emanueca/zenit_science/assets/files/slides/ZENIT_slide.pdf

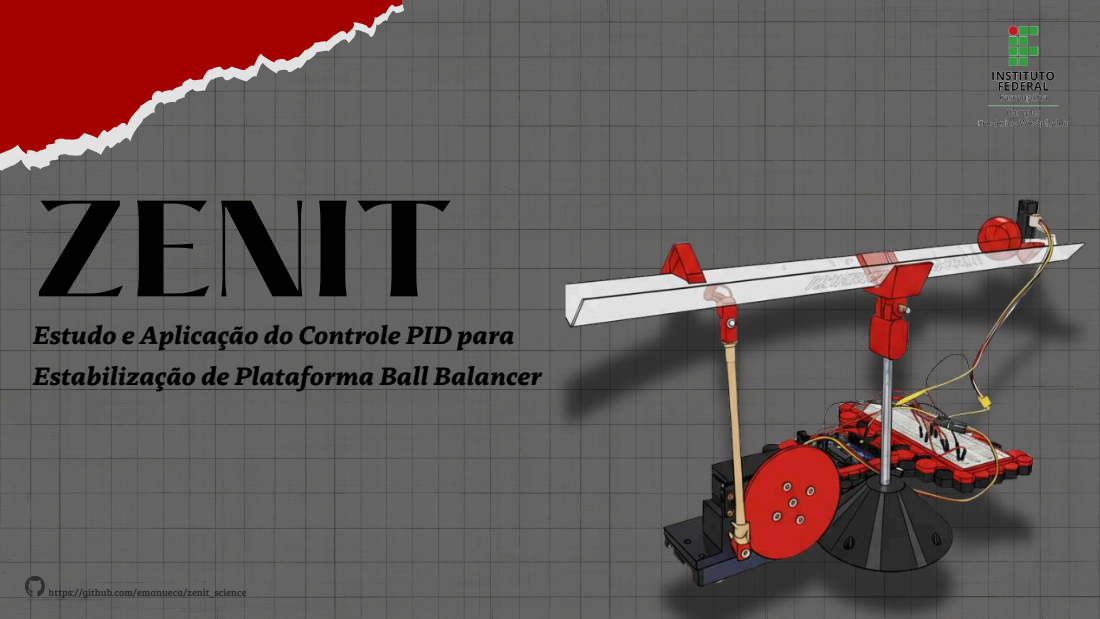
[picture p1: page 1]
ZEstudo e; EAplica; Nção do C; ontr

Tole PID para

Estabilização de Plataforma Ball Balancer

https://github.com/emanueca/zenit_science

# FFííssiiccaa

# CONCEITO CIENTÍFICO

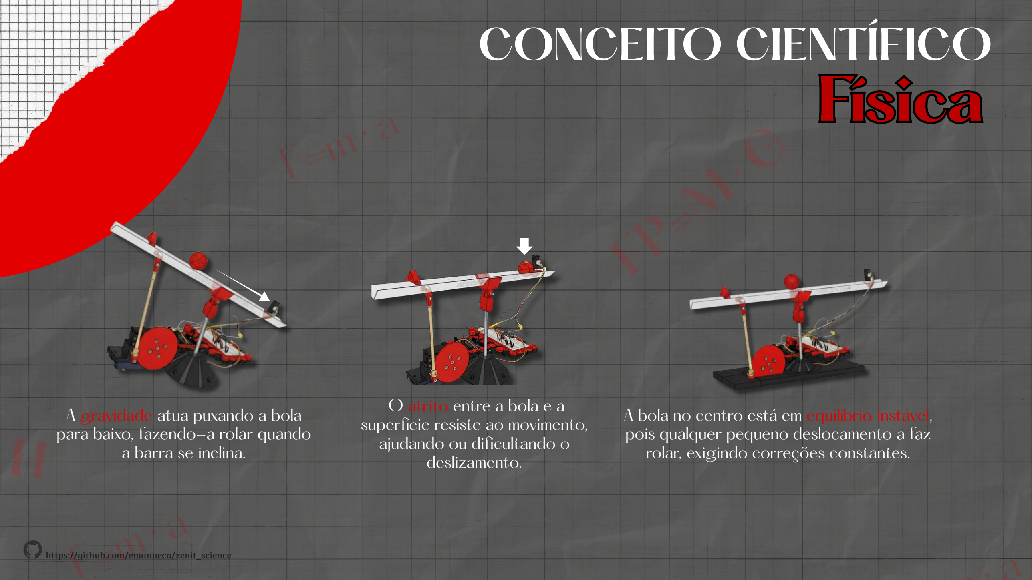
[picture p2: page 2]

## O atrito entre a bola e a

superfície resiste ao movimento,

## ajudando ou dificultando o

deslizamento.

# FP=M⋅G

H

## A gravidade atua puxando a bola para baixo, fazendo-a rolar quando

a barra se inclina.

A bola no centro está em equilíbrio instável,

## pois qualquer pequeno deslocamento a faz

rolar, exigindo correções constantes.

# F=m⋅a

# F=m⋅a

⋅a

# Proporcional :

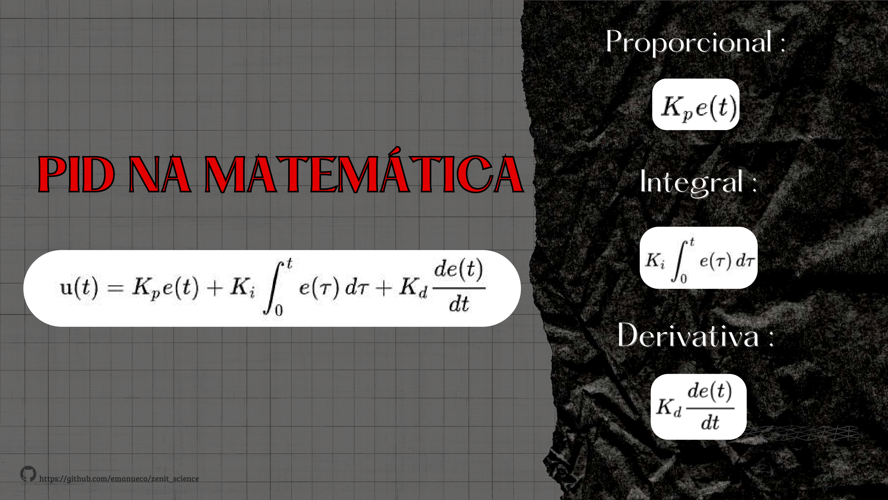
[picture p3: page 3]

# PID NA MATEMÁTICA

# Integral :

# Derivativa :

# FUNCIONAMENTO DO PROJETO

# SENSOR SHARP

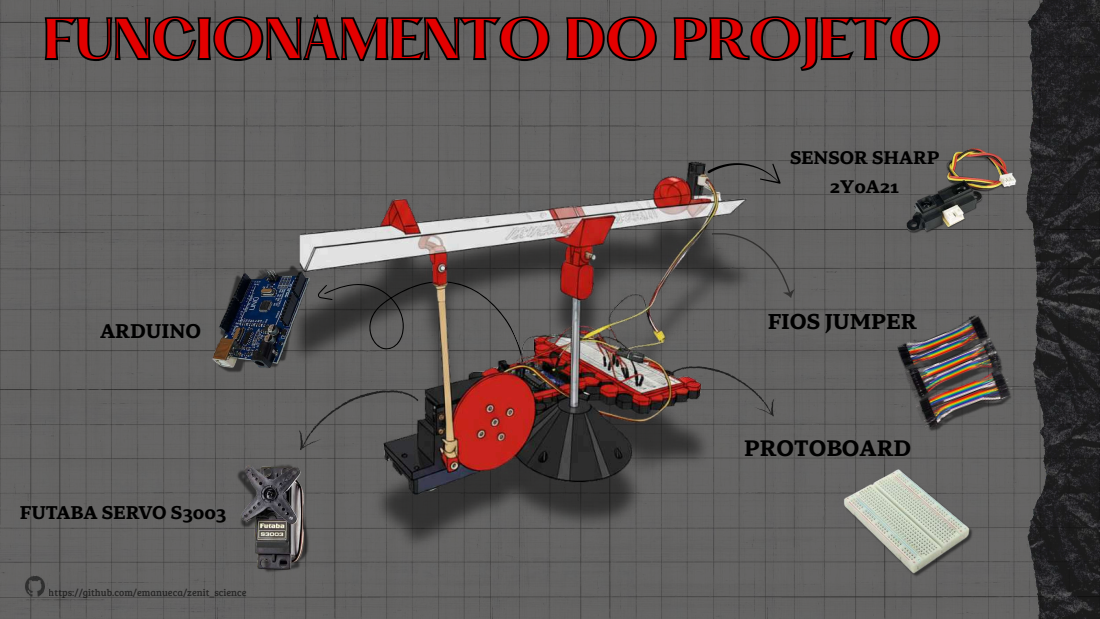
[picture p4: page 4]
FUTABA SERVO S3003; ARDUINO; FIOS JUMPER; PROTOBOARD

## TRILHO DE ENERGIA

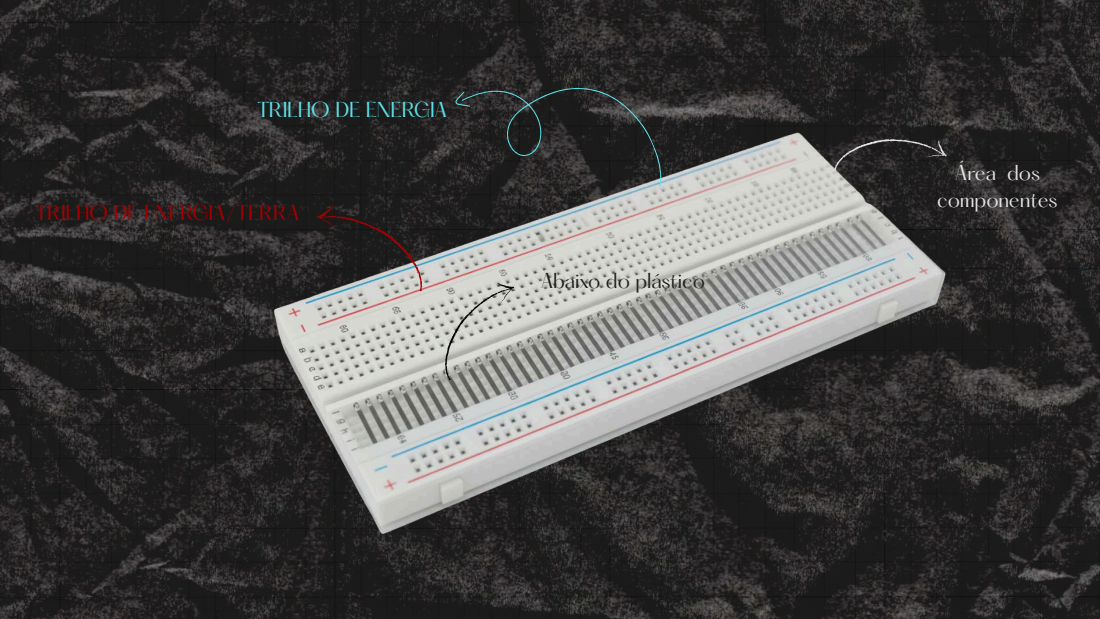
[picture p5: page 5]
Área dos componentes

TRILHO DE ENERGIA/TERRA

Abaixo do plástico

# Peças iimmpprreessssaass eemm 33dd

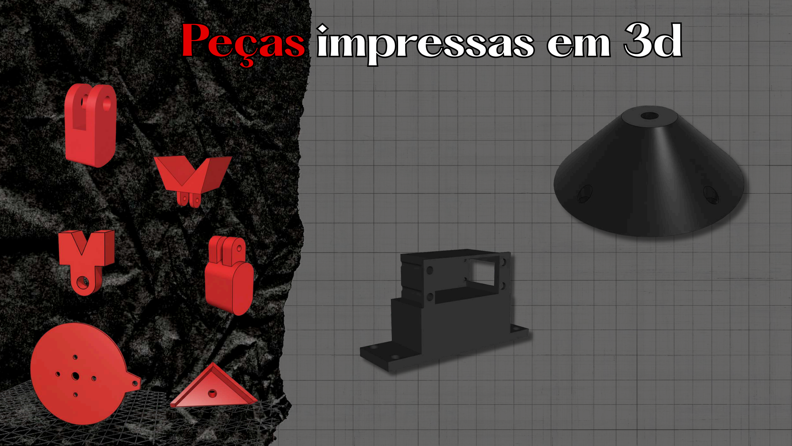
[picture p6: page 6]

# APLICAÇÕES DO PID

# Indústria

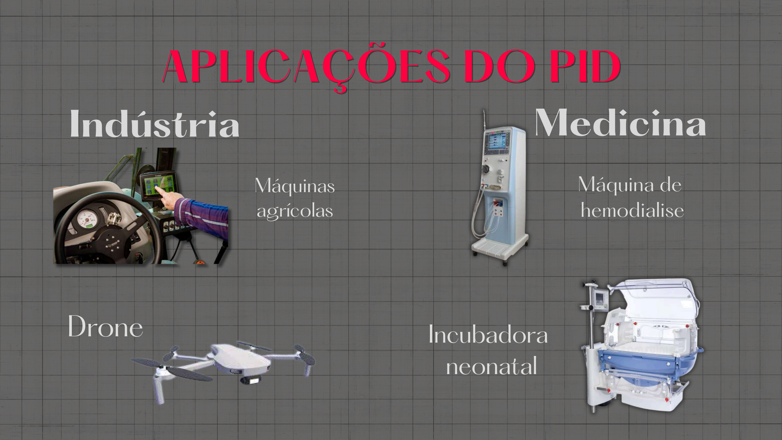
[picture p7: page 7]

# Medicina

# Drone

# Máquinas agrícolas

# Incubadora neonatal

# Máquina de hemodialise

# APLICAÇÕES DO PID

# Veículos

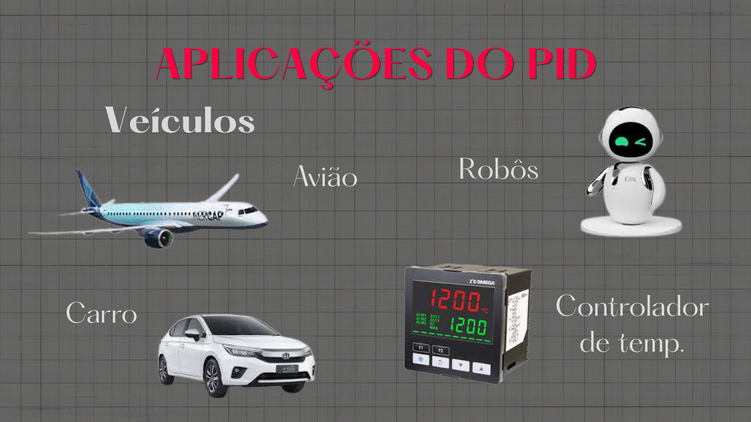
[picture p8: page 8]

# Carro

Avião | Robôs

# Controlador

de temp.

# IMAGENS DO PROCESSO

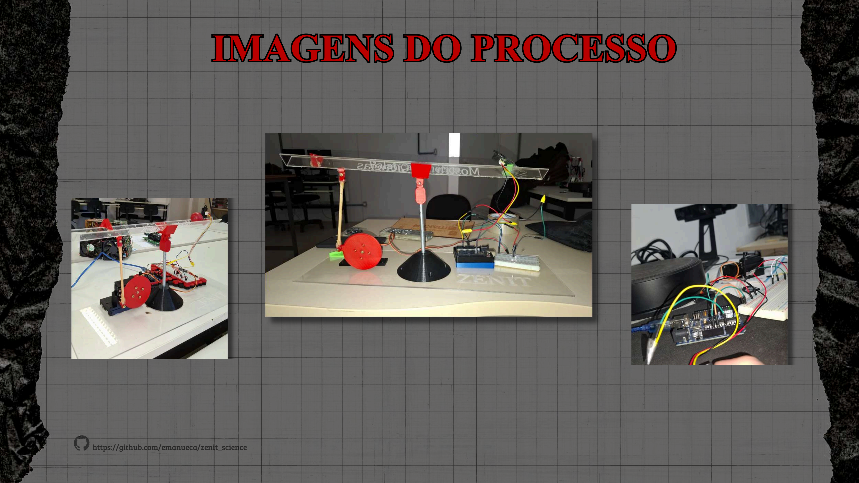
[picture p9: page 9]
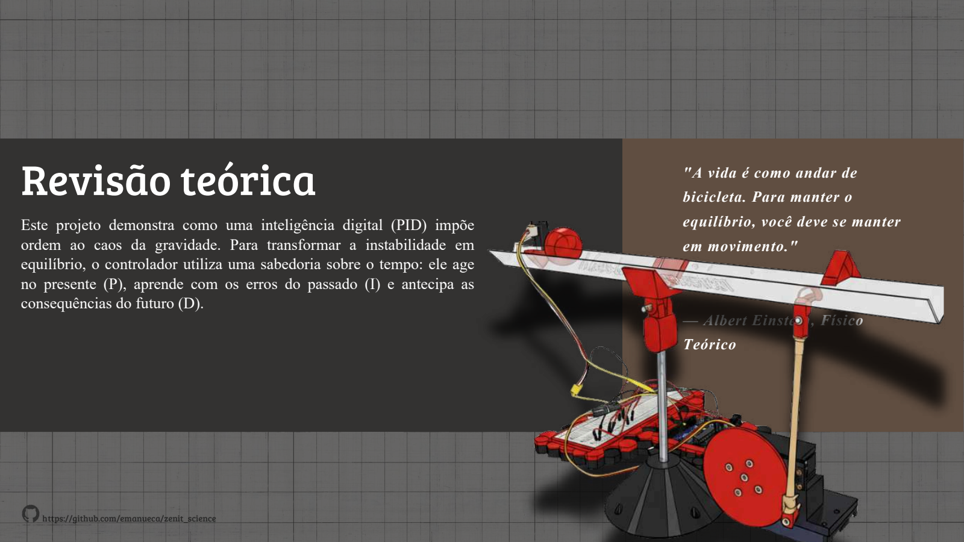
[picture p10: page 10]

## "A vida é como andar de bicicleta. Para manter o equilíbrio, você deve se manter em movimento."

## — Albert Einstein, Físico Teórico

## Este projeto demonstra como uma inteligência digital (PID) impõe ordem ao caos da gravidade. Para transformar a instabilidade em equilíbrio, o controlador utiliza uma sabedoria sobre o tempo: ele age no presente (P), aprende com os erros do passado (I) e antecipa as

consequências do futuro (D).

# Revisão teórica

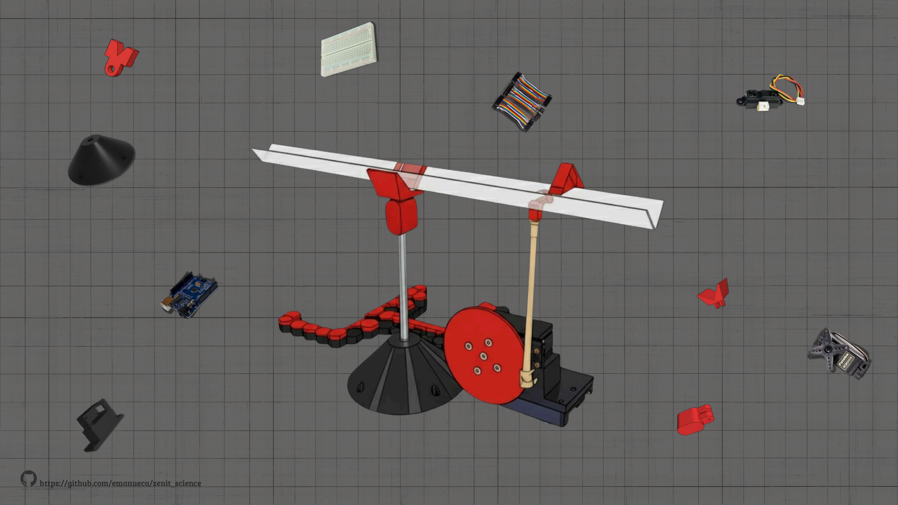
[picture p11: page 11]
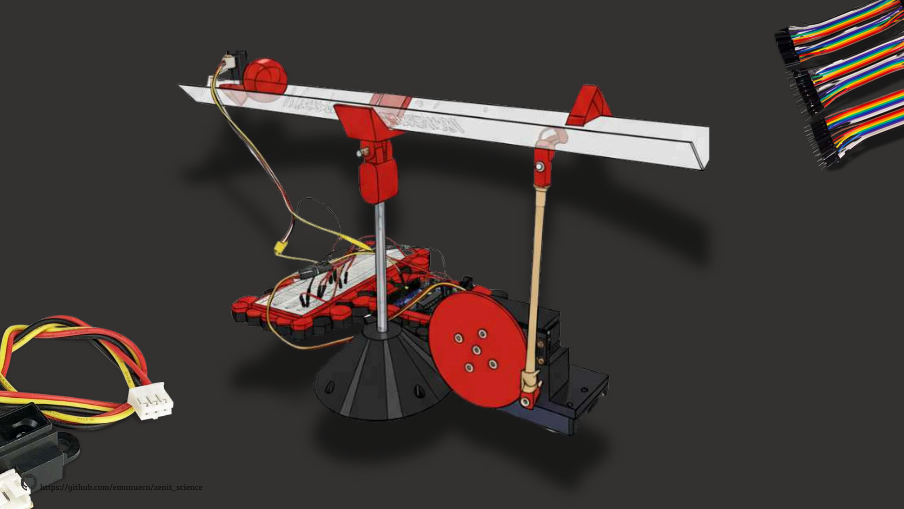
[picture p12: page 12]
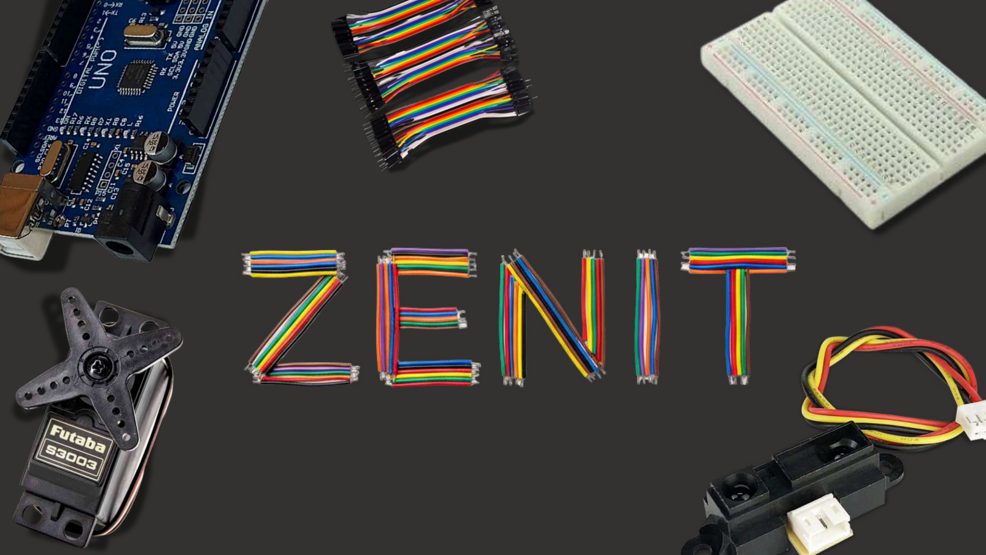
[picture p13: page 13]

# VOTE 132
