emanueca/zenit_science/assets/files/3dFiles/Small_hinge_1.stl

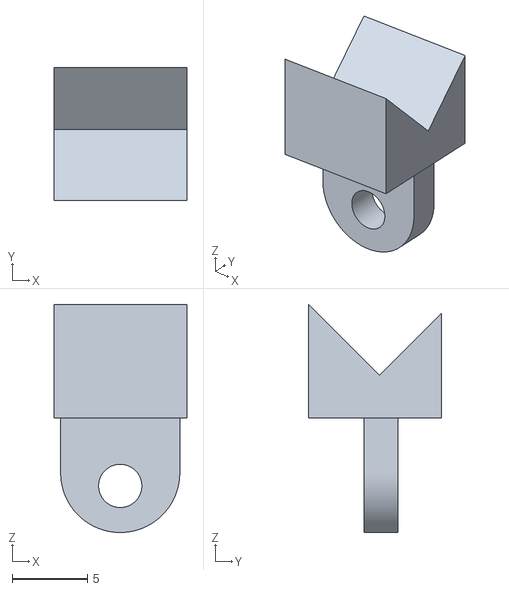
[picture p14: CAD file, 2025-09-03]
assets/files/3dFiles/Small_hinge_1.stl
8.83 x 8.83 x 15.2
