emanueca/zenit_science/assets/files/3dFiles/Hinge_2.stl

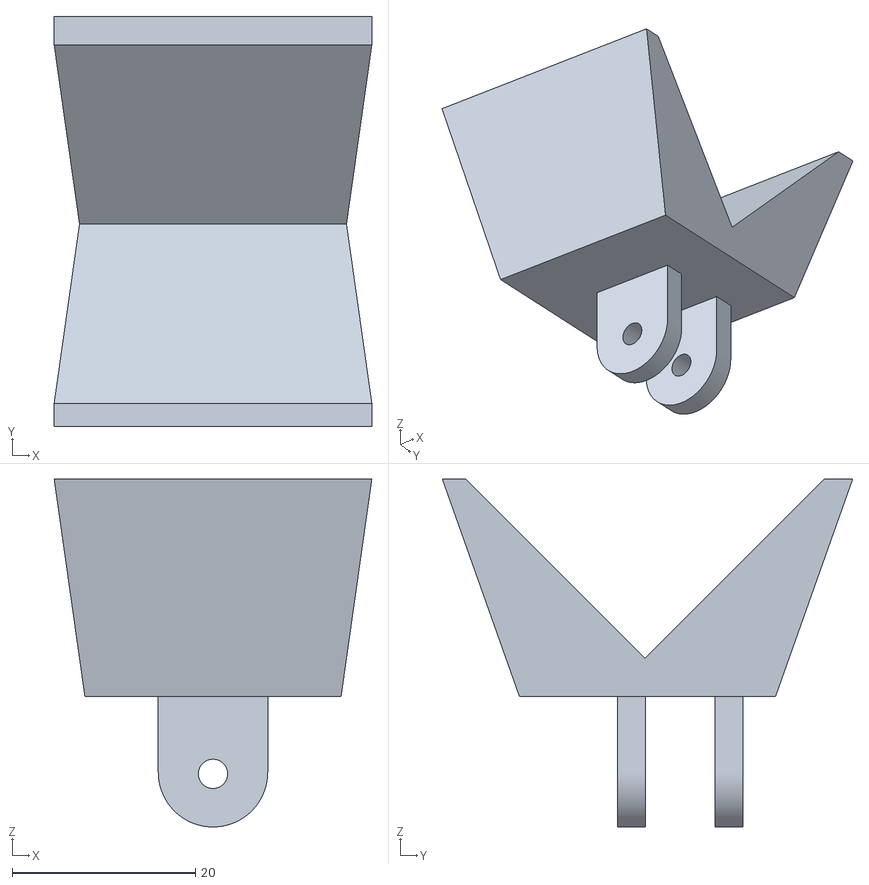
[picture p15: CAD file, 2025-09-03]
assets/files/3dFiles/Hinge_2.stl
34.7 x 44.8 x 38.0
