emanueca/zenit_science/assets/files/3dFiles/Base.stl

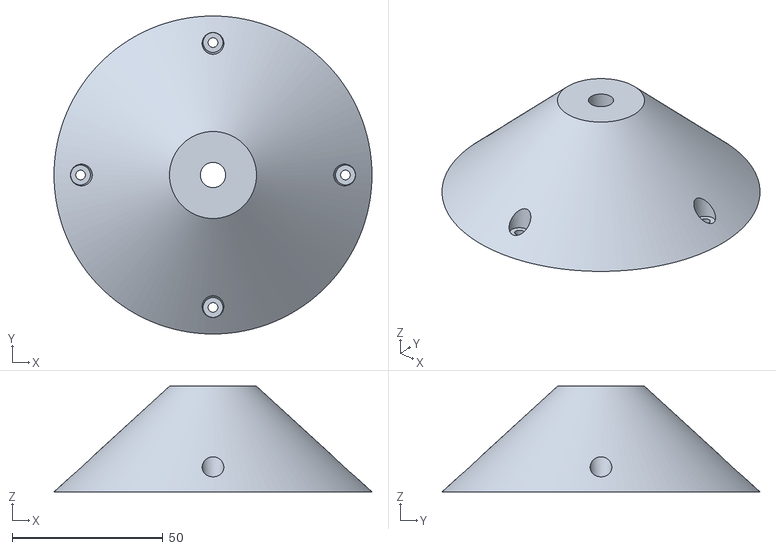
[picture p16: CAD file, 2025-09-03]
assets/files/3dFiles/Base.stl
105.6 x 105.6 x 35.1
