emanueca/zenit_science/assets/files/3dFiles/Small_hinge_2.stl

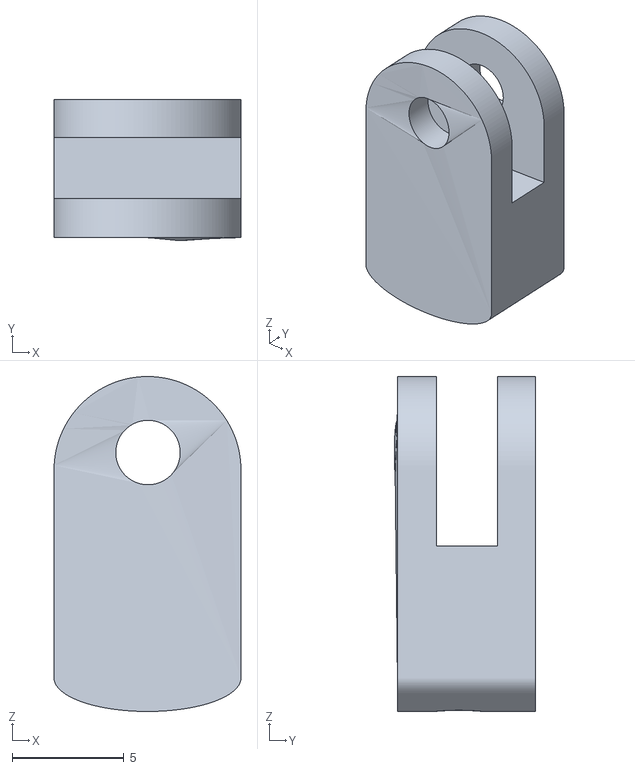
[picture p17: CAD file, 2025-09-03]
assets/files/3dFiles/Small_hinge_2.stl
8.37 x 6.33 x 15.0
