emanueca/zenit_science/assets/files/3dFiles/Disc3.stl

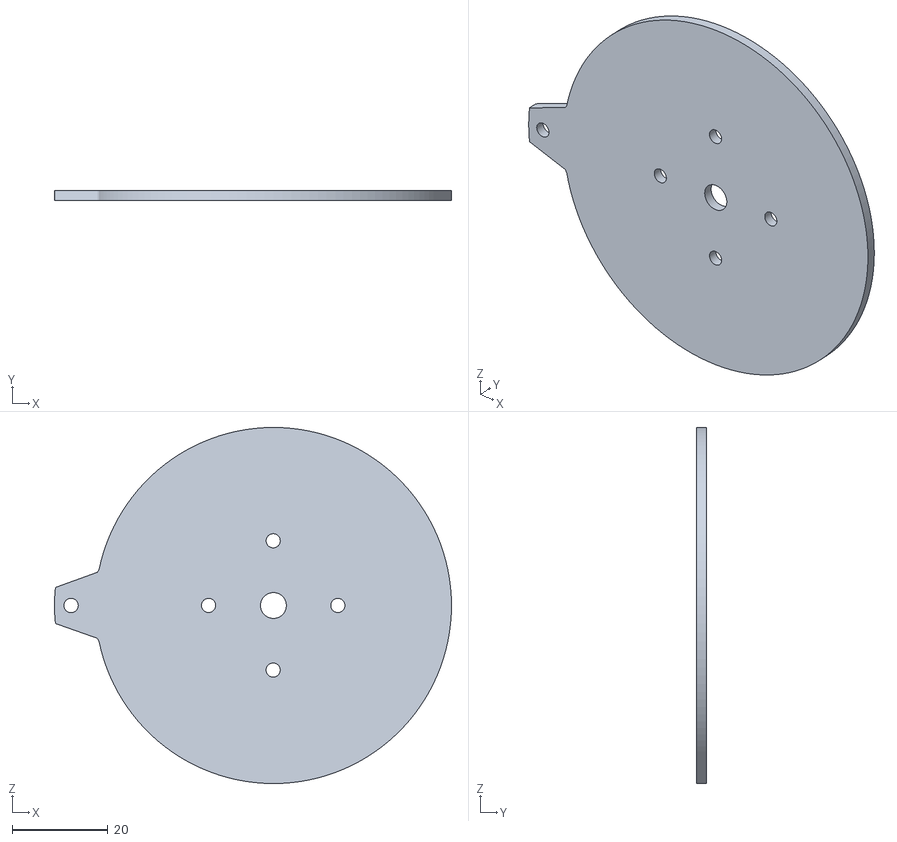
[picture p18: CAD file, 2025-09-03]
assets/files/3dFiles/Disc3.stl
82.9 x 2.00 x 74.4
