emanueca/zenit_science/assets/files/3dFiles/Small_hinge_3.stl

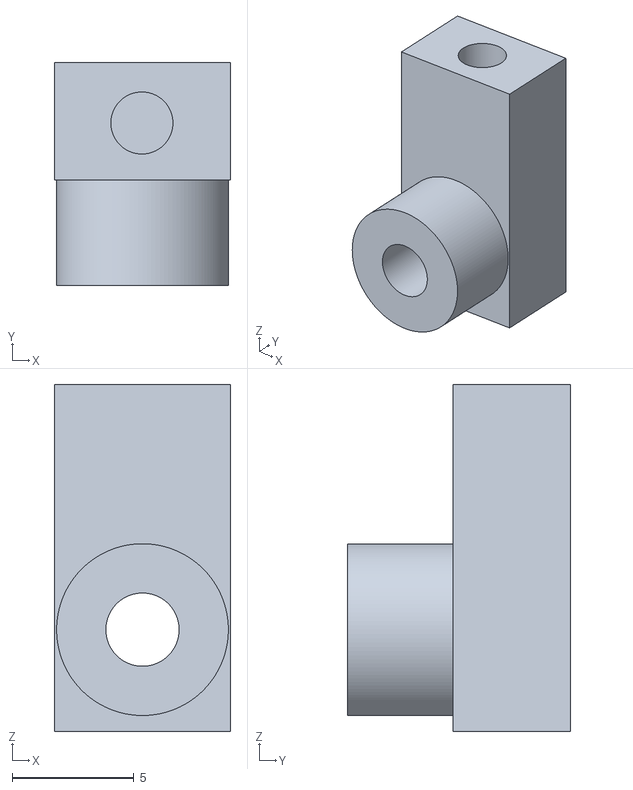
[picture p19: CAD file, 2025-09-03]
assets/files/3dFiles/Small_hinge_3.stl
7.23 x 9.14 x 14.2
