emanueca/zenit_science/assets/files/3dFiles/Hinge_1.stl

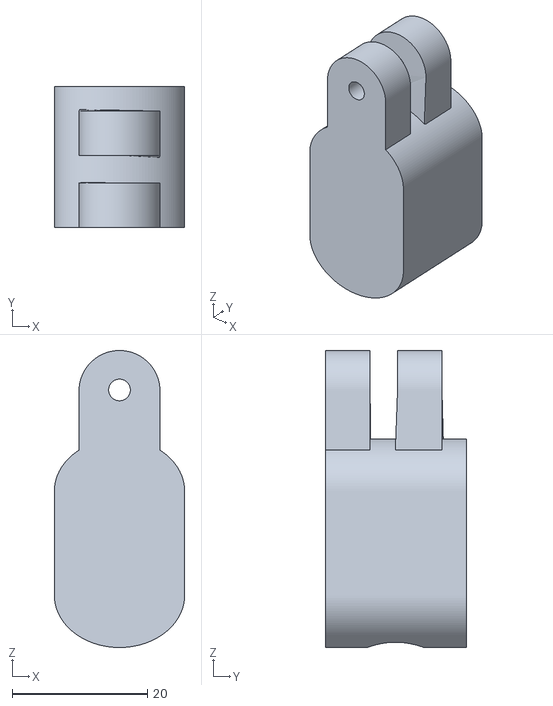
[picture p20: CAD file, 2025-09-03]
assets/files/3dFiles/Hinge_1.stl
19.2 x 20.8 x 43.9
