emanueca/zenit_science/assets/files/3dFiles/Disc2.stl

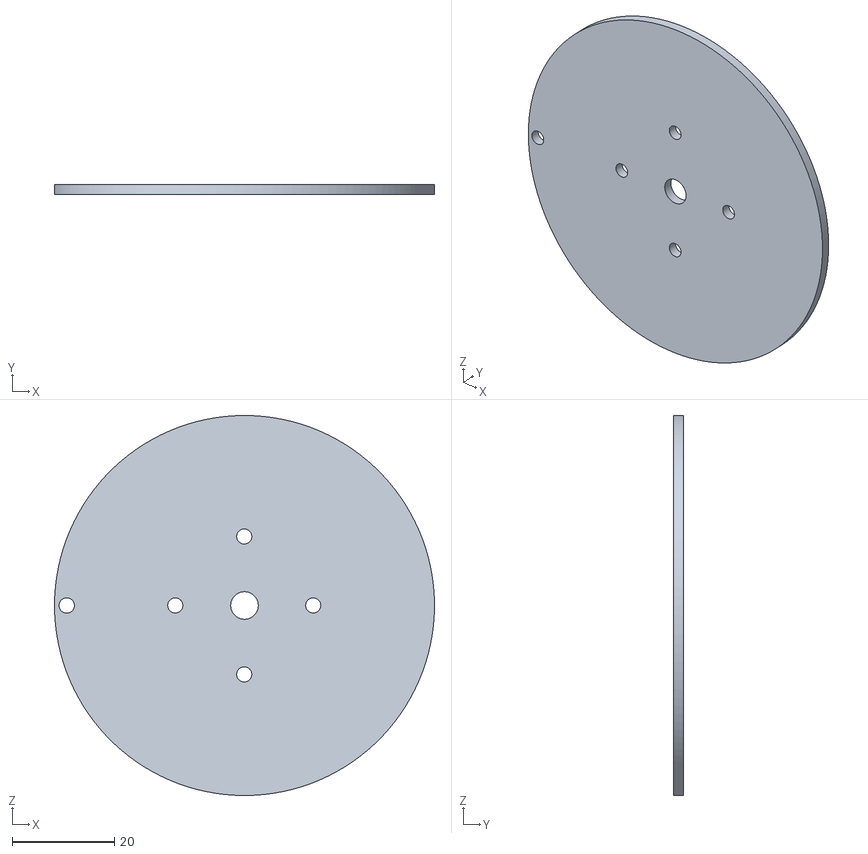
[picture p21: CAD file, 2025-09-03]
assets/files/3dFiles/Disc2.stl
74.4 x 2.00 x 74.4
