emanueca/zenit_science/assets/files/3dFiles/Servo_support.stl

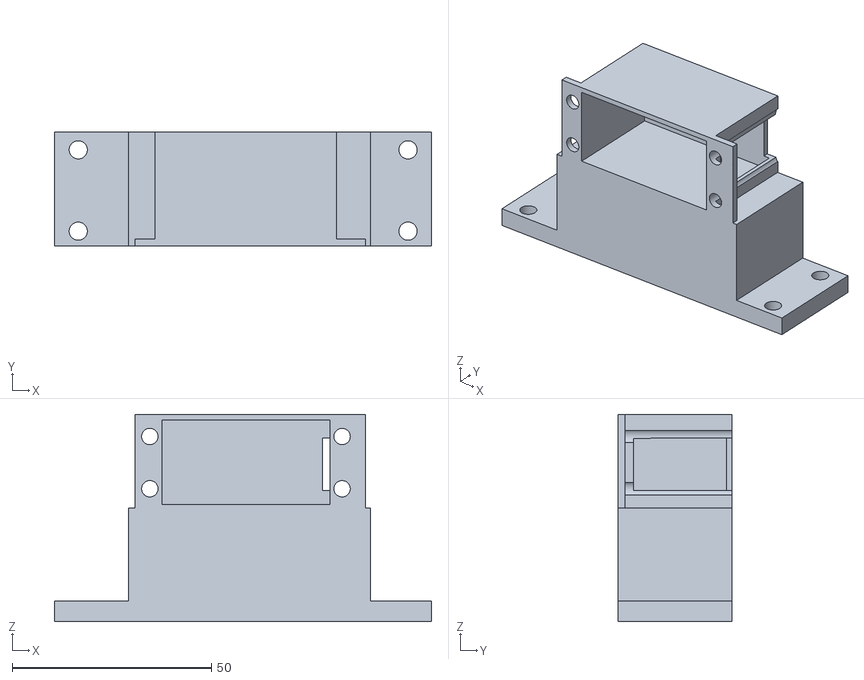
[picture p22: CAD file, 2025-09-03]
assets/files/3dFiles/Servo_support.stl
94.6 x 28.7 x 51.9
