emanueca/zenit_science/assets/files/3dFiles/Disc.stl

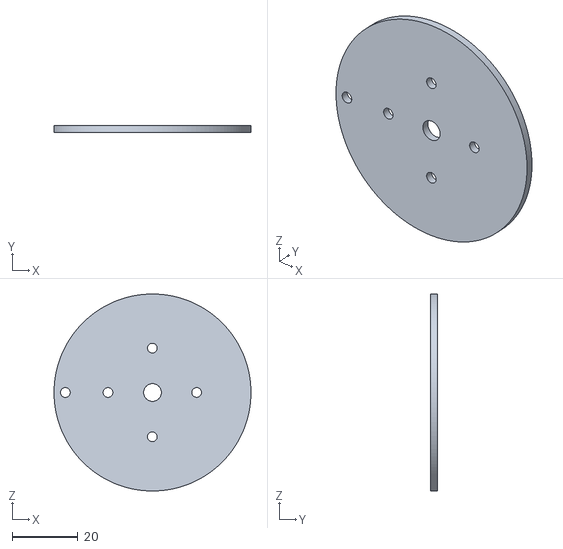
[picture p23: CAD file, 2025-09-03]
assets/files/3dFiles/Disc.stl
60.0 x 2.00 x 60.0
