emanueca/zenit_science/assets/files/3dFiles/End_stop.stl

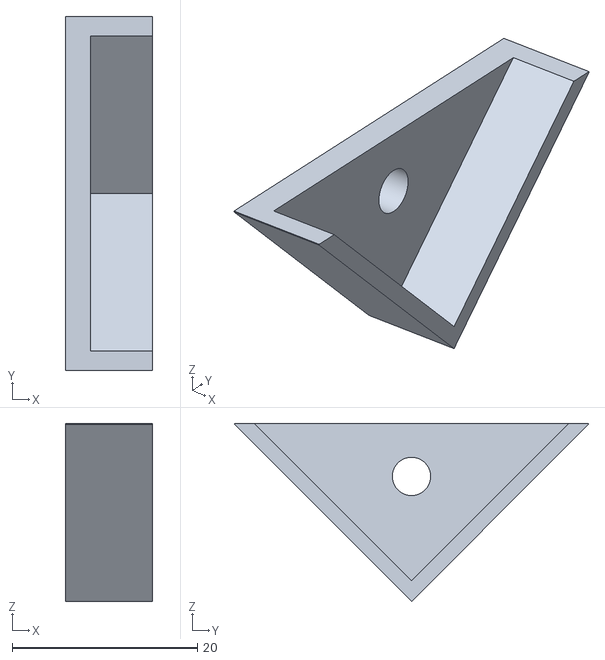
[picture p24: CAD file, 2025-09-03]
assets/files/3dFiles/End_stop.stl
9.42 x 38.2 x 19.2
