emanueca/zenit_science/(commit log)

2025-09-03 ELECTRONOOBS FILES_3D
    https://www.youtube.com/watch?v=JFTJ2SS4xyA
    [Base.stl, Disc.stl, Disc2.stl, Disc3.stl, End_stop.stl, Hinge_1.stl, Hinge_2.stl, Servo_support.stl]
2025-09-22 Create Motor_servo
2025-09-22 Update and rename Tuturial/Motor_servo to Tuturial/motor_servo/arq
2025-09-22 Create sensor_equilibrio
2025-09-27 general project update
    [Base.stl, Disc.stl, Disc2.stl, Disc3.stl, End_stop.stl, Hinge_1.stl, Hinge_2.stl, Servo_support.stl]
